ebtrac/Videonics-PP-1-Bluetooth-Mod/videonics processor plus ebtracMod.jpg

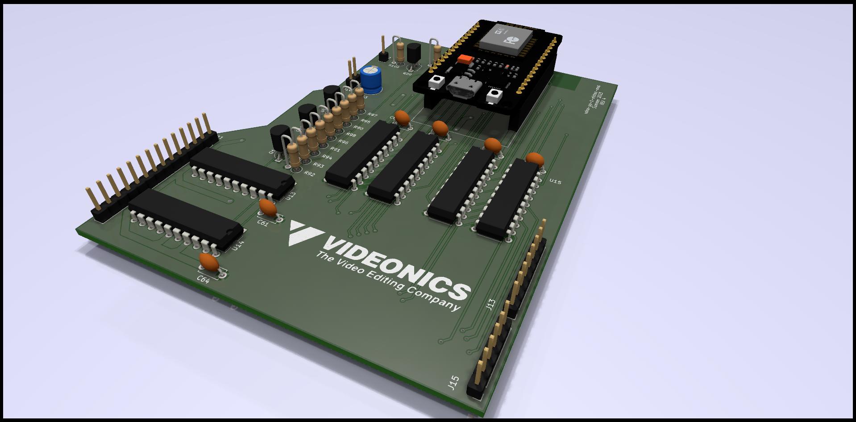
videonics processor plus ebtracMod.jpg
