ebtrac/Videonics-PP-1-Bluetooth-Mod/README.md

# Important Note  
This modification is not tested yet. Please check back when a fully tested modification has been developed.  
Modify your device at your own risk!  

# Videonics-PP-1-Bluetooth-Mod
 KiCad 6.0 Project Files for the Videonics Processor Plus and modifications for adding bluetooth control.
- [Schematics](20230723%20ebtrac_mod_pp1_rev4.pdf)
- [Firmware](https://github.com/ebtrac/pp1_esp32_control)
