ebtrac/Videonics-PP-1-Bluetooth-Mod/20230723 ebtrac_mod_pp1_rev4.pdf

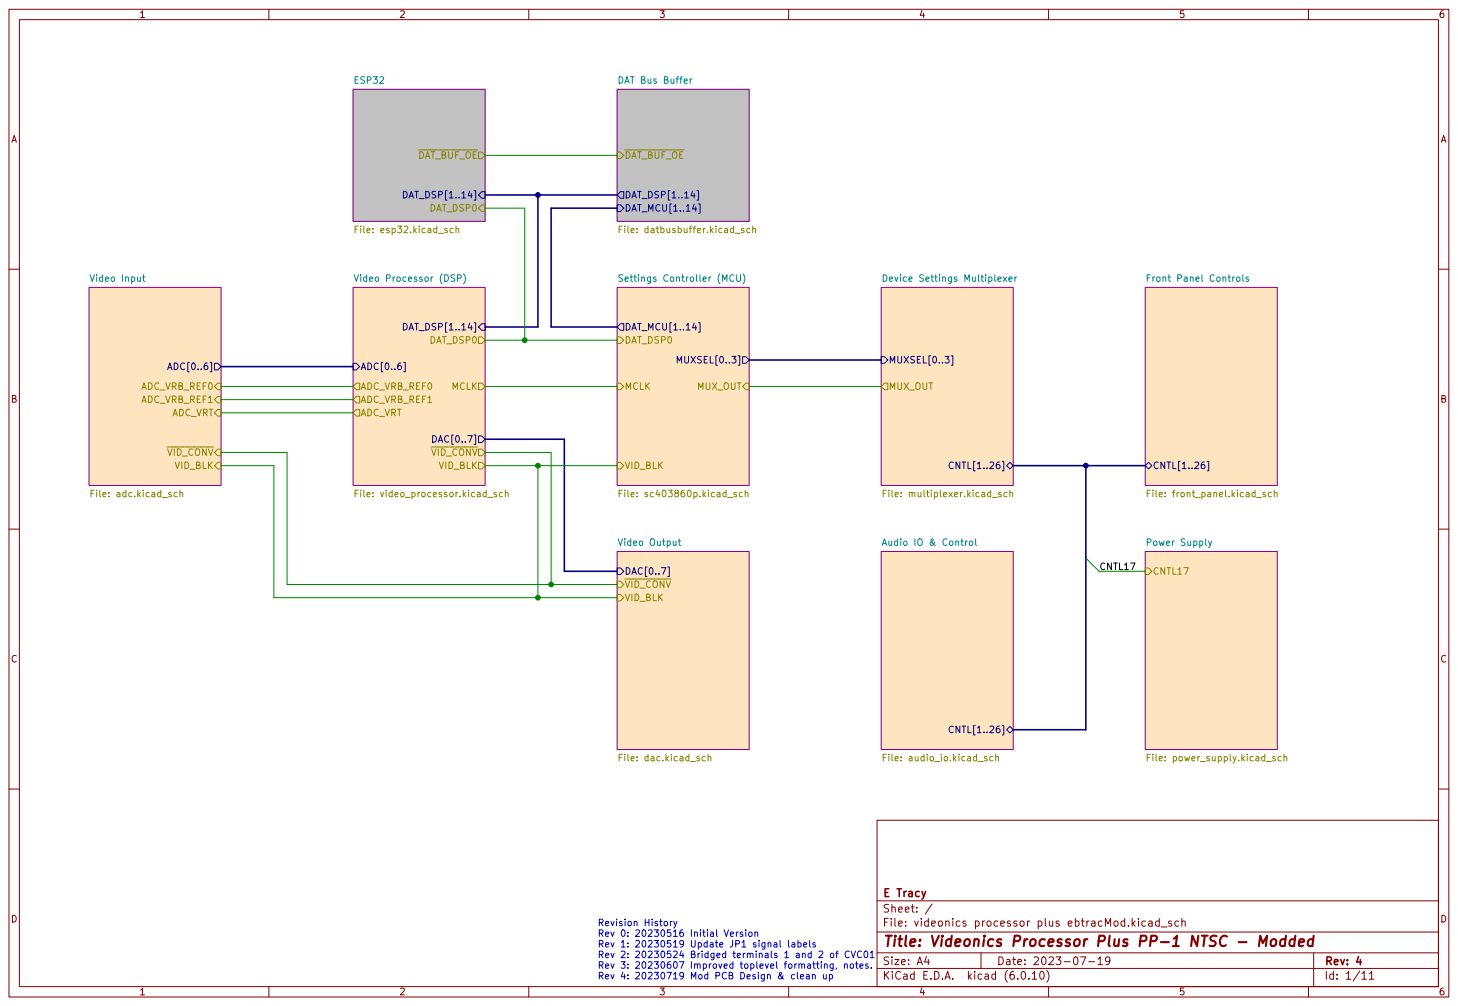
[picture p3: page 1]

CNTL[1..26] Front Panel Controls File: front_panel.kicad_sch

CNTL[1..26] MUX_OUT Device Settings Multiplexer

~{VID_CONV}
Video Output File: dac.kicad_sch VID_BLK

File: videonics processor plus ebtracMod.kicad_sch Sheet: / E Tracy

Id: 1/11 Title: Videonics Processor Plus PP-1 NTSC - Modded

Rev 2: 20230524 Bridged terminals 1 and 2 of CVC01
Rev 3: 20230607 Improved toplevel formatting, notes.
Rev 4: 20230719 Mod PCB Design & clean up

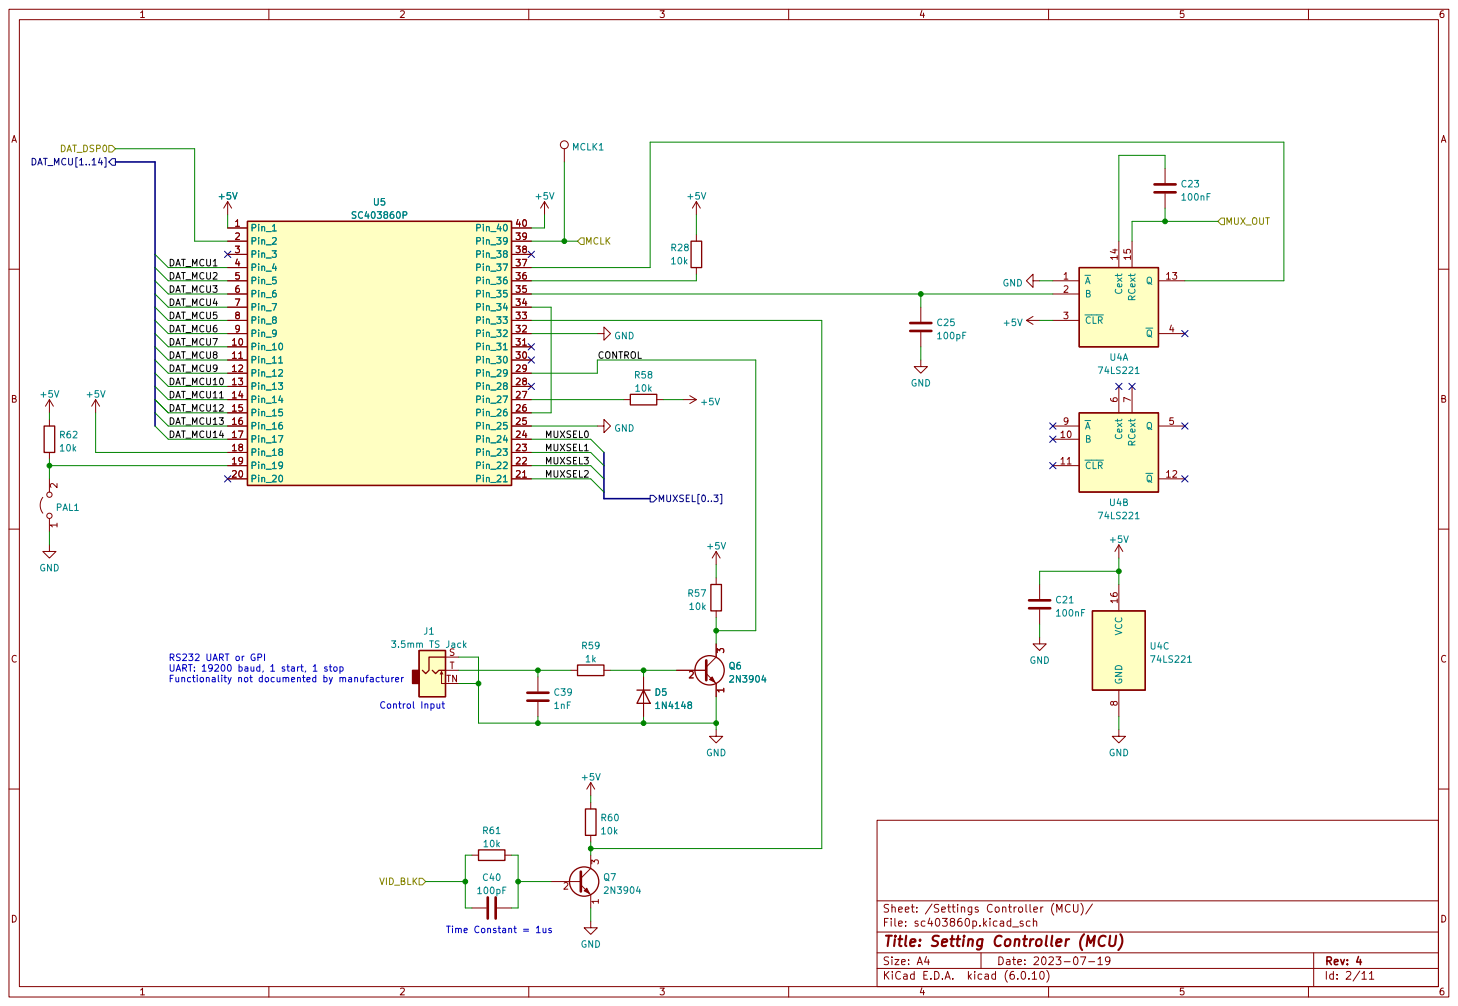
[picture p4: page 2]

Functionality not documented by manufacturer

File: sc403860p.kicad_sch
Id: 2/11 Title: Setting Controller (MCU)

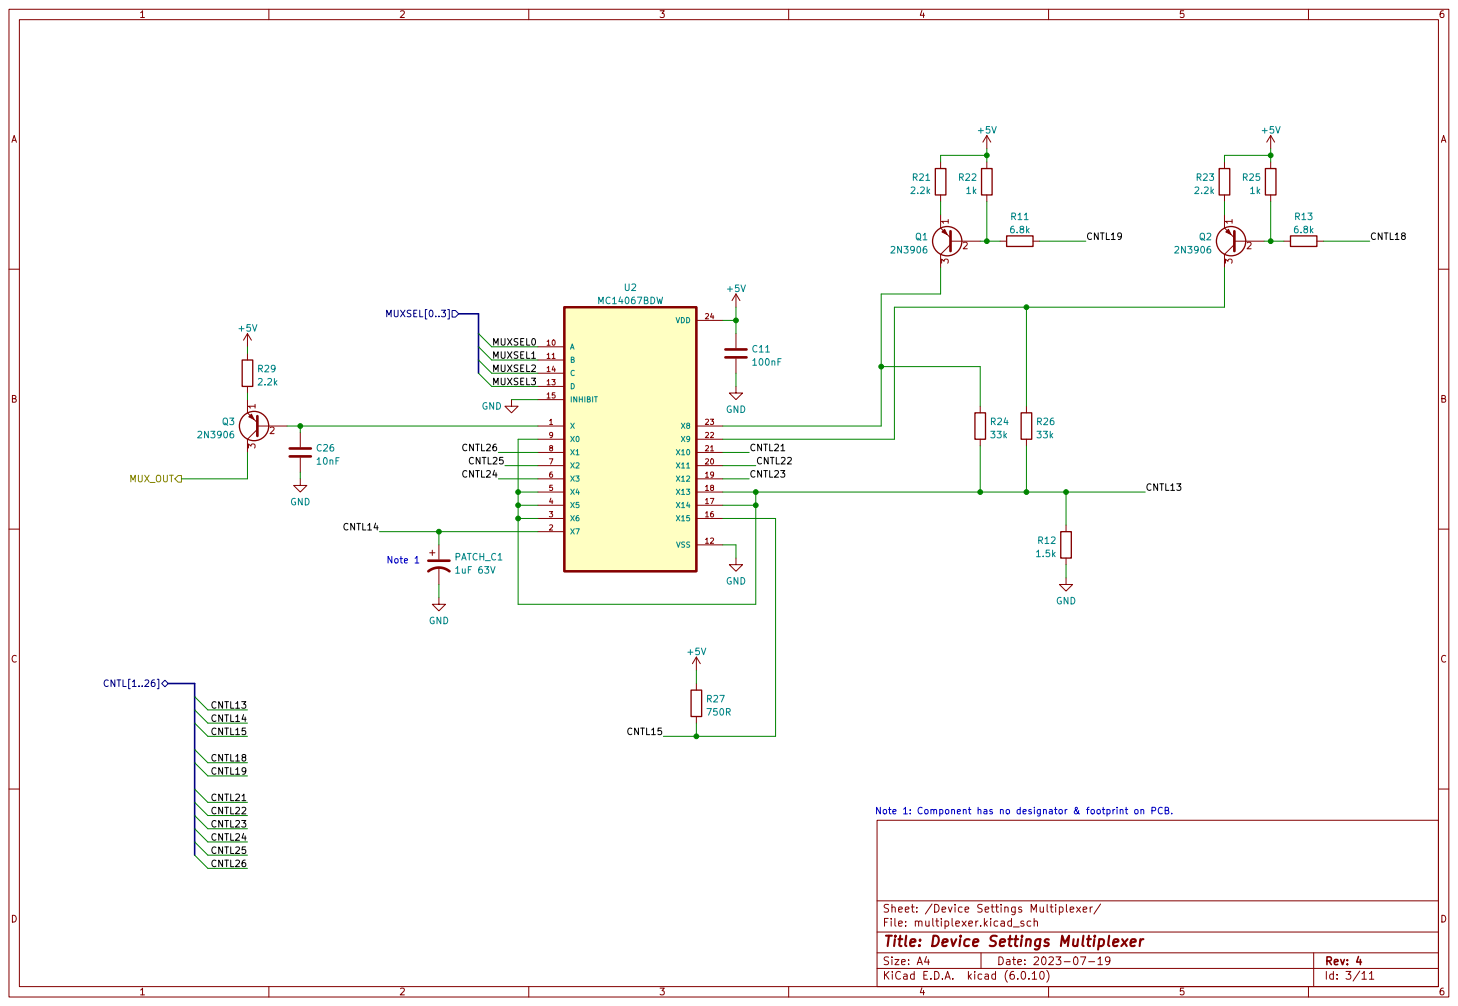
[picture p5: page 3]

Sheet: /Device Settings Multiplexer/
File: multiplexer.kicad_sch
Id: 3/11 Title: Device Settings Multiplexer

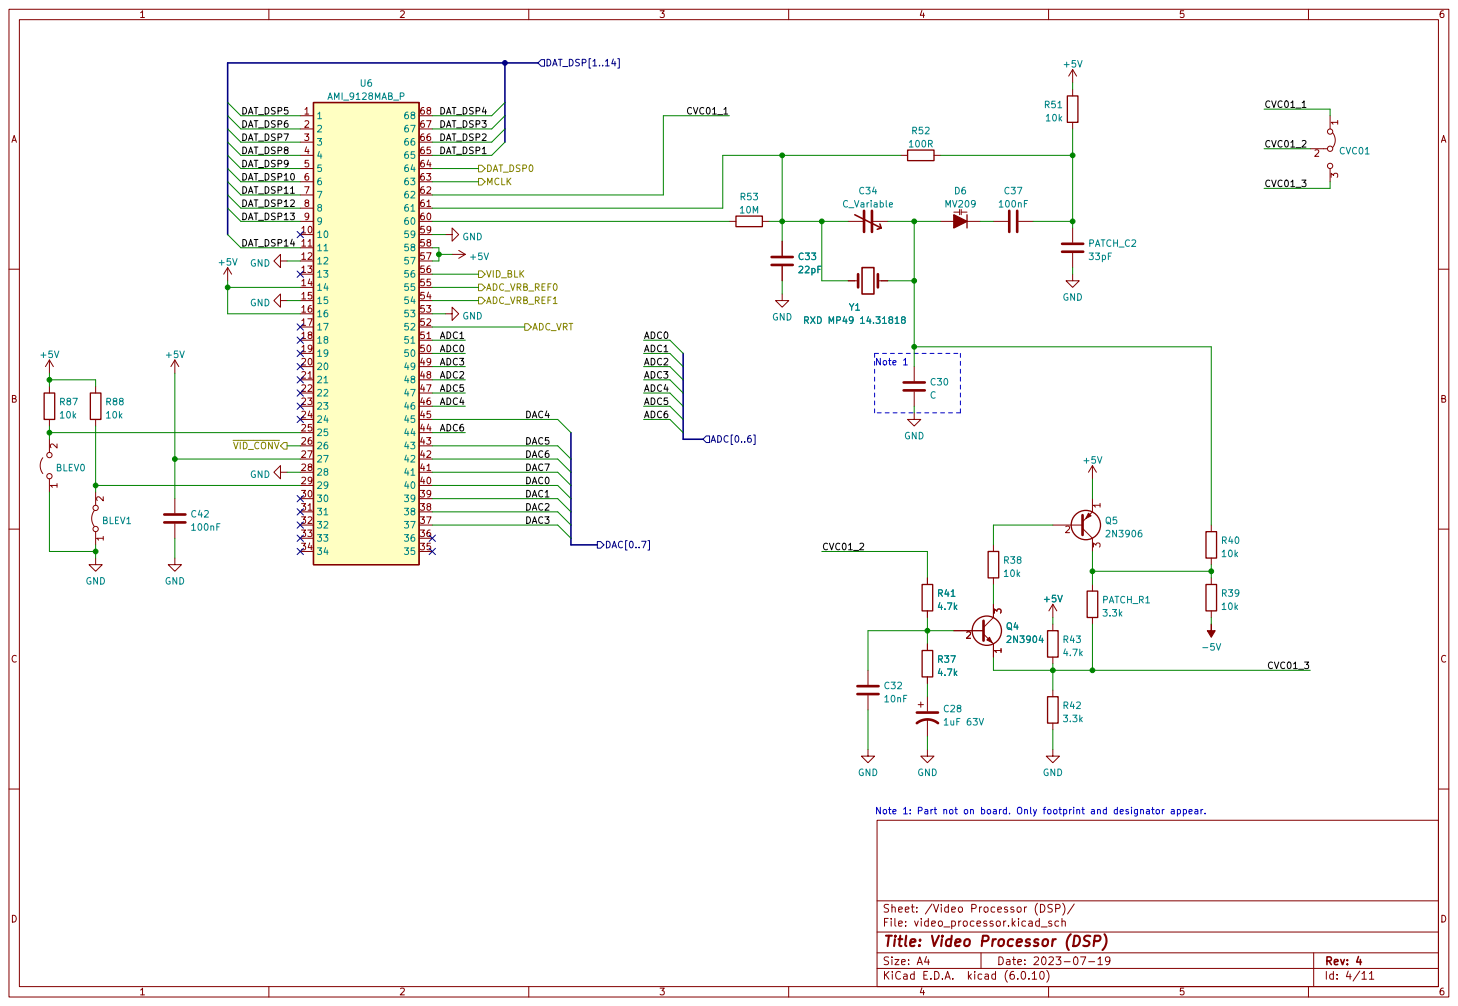
[picture p6: page 4]

Sheet: /Video Processor (DSP)/
File: video_processor.kicad_sch
Id: 4/11 Title: Video Processor (DSP)

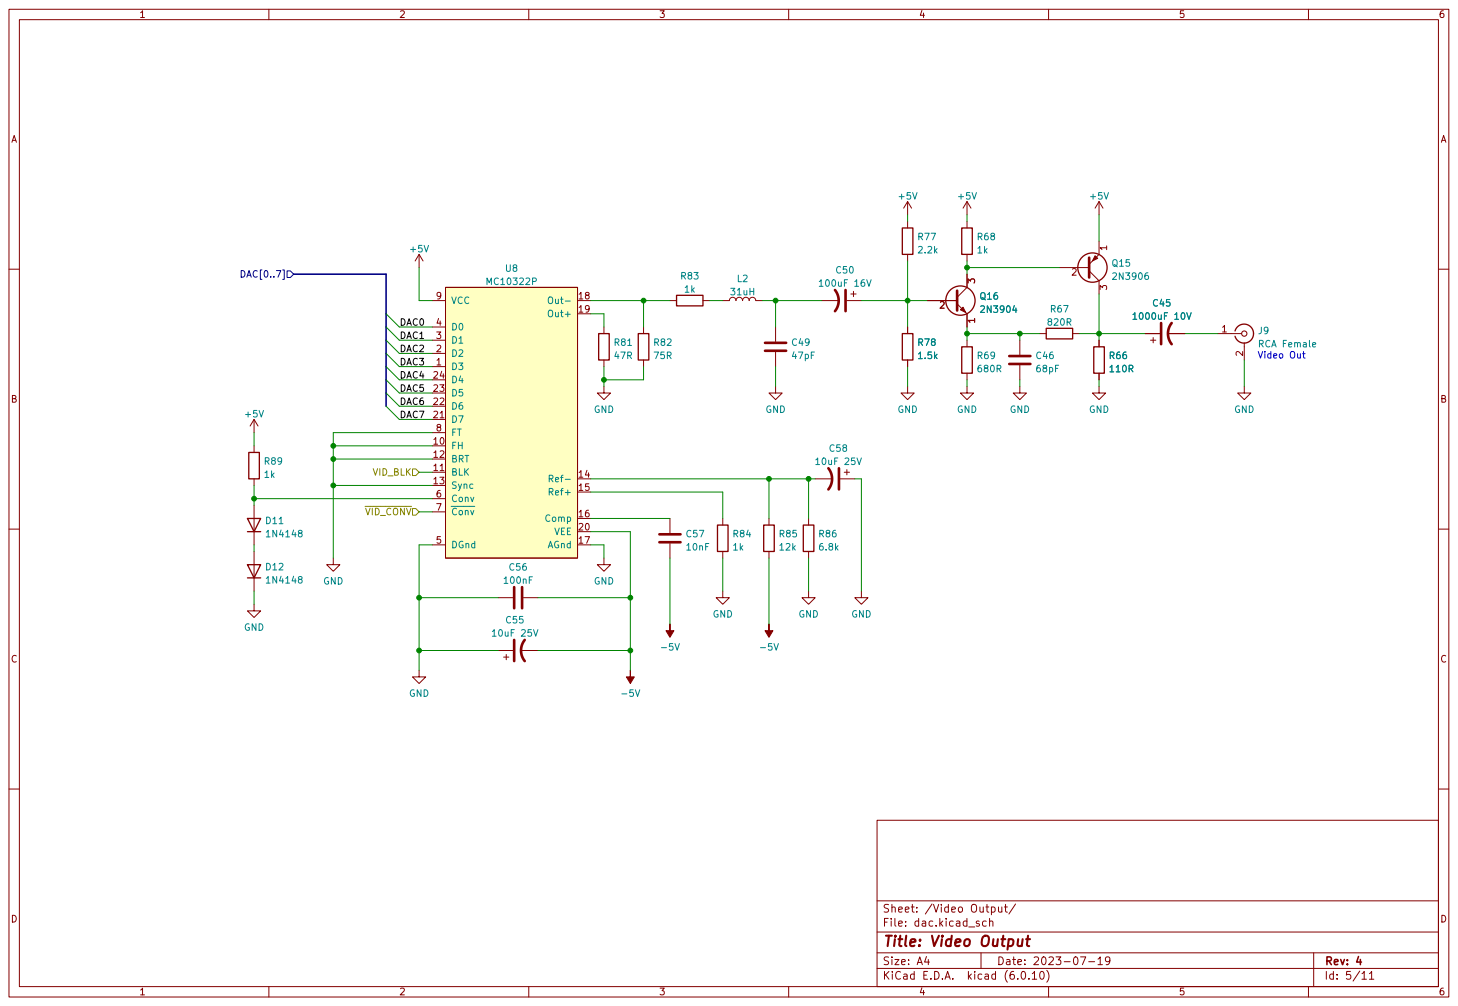
[picture p7: page 5]

Sheet: /Video Output/
File: dac.kicad_sch
Id: 5/11 Title: Video Output

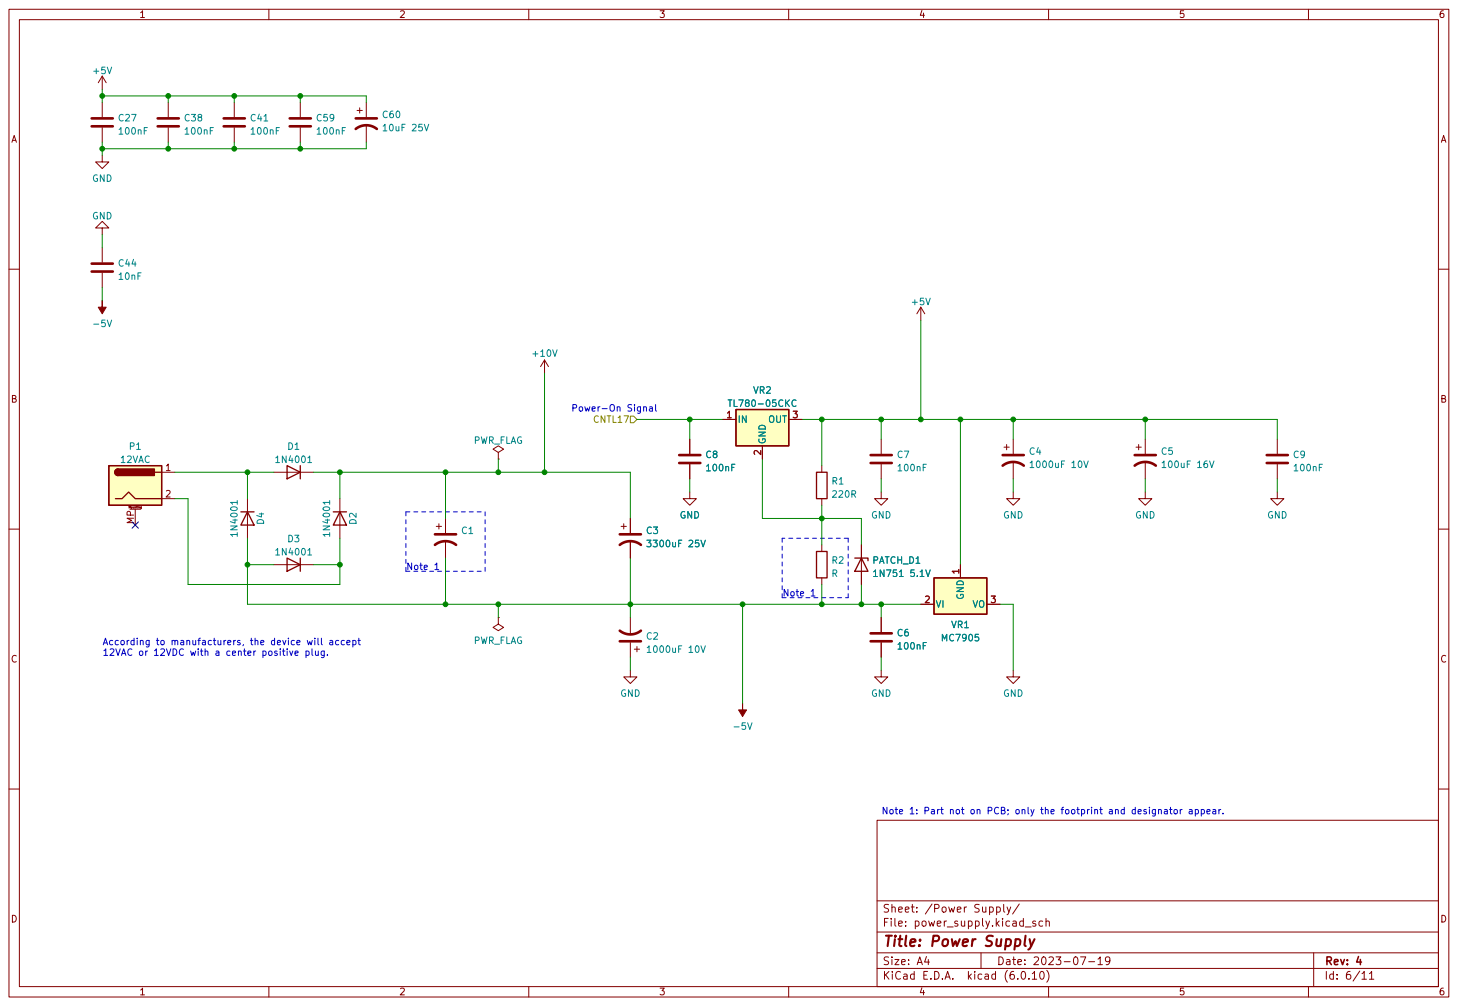
[picture p8: page 6]

100nF CNTL17 According to manufacturers, the device will accept

12VAC or 12VDC with a center positive plug.

File: power_supply.kicad_sch
Id: 6/11 Title: Power Supply

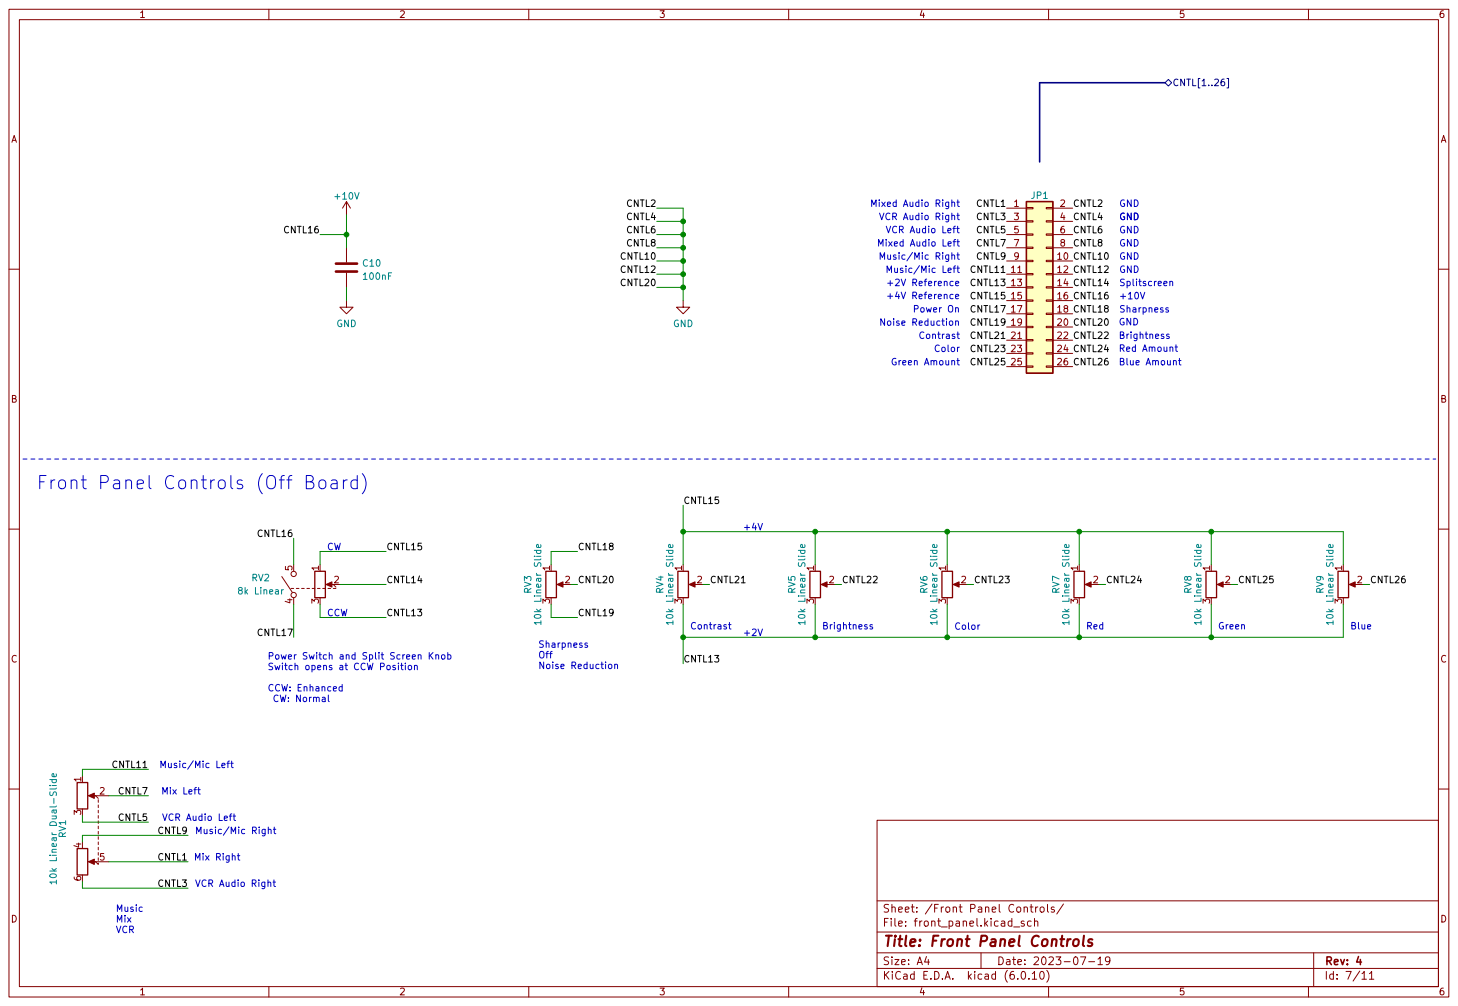
[picture p9: page 7]

VCR Audio Left VCR Audio Right Mixed Audio Left +2V Reference +4V Reference

Power Switch and Split Screen Knob
Switch opens at CCW Position CCW: Enhanced

CW: Normal Music/Mic Right

Mix Right VCR Audio Left

File: front_panel.kicad_sch Sheet: /Front Panel Controls/
Id: 7/11 Title: Front Panel Controls

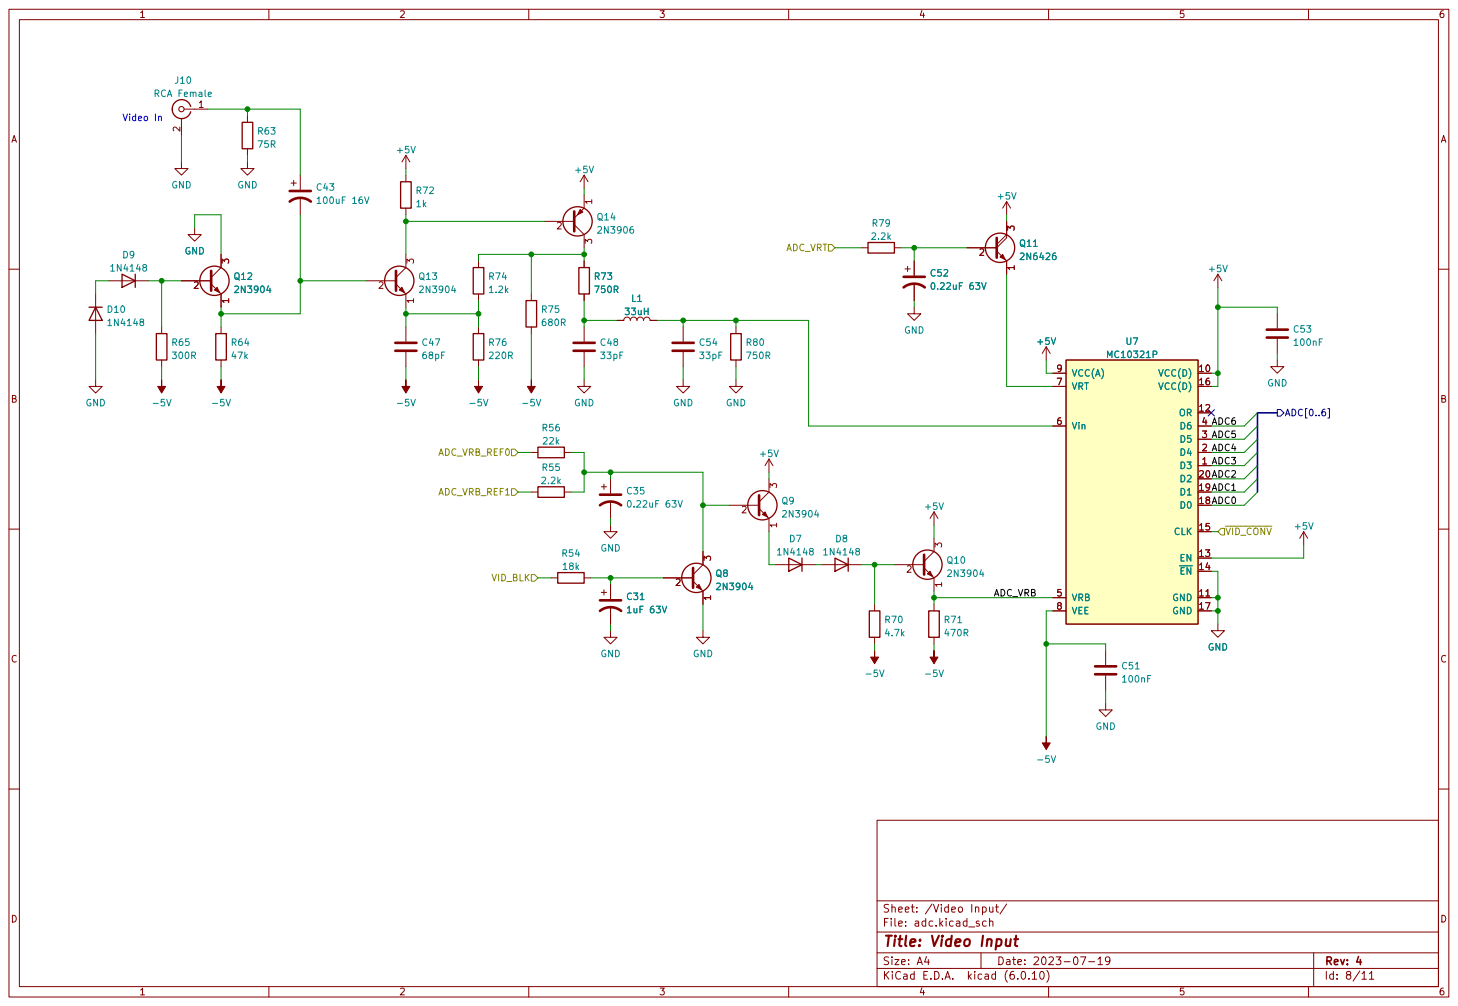
[picture p10: page 8]

3 U7 MC10321P D3 1 VCC(D) 10 GND 11 OR 12 EN 13 ~{EN} 14 CLK 15 VCC(D) 16 GND 17 D0 18 D1 19 D4 2 D2 20 D5 3 D6 4 VRB 5 Vin 6 VRT 7 VEE 8 VCC(A) 9 GND

File: adc.kicad_sch
Id: 8/11 Title: Video Input

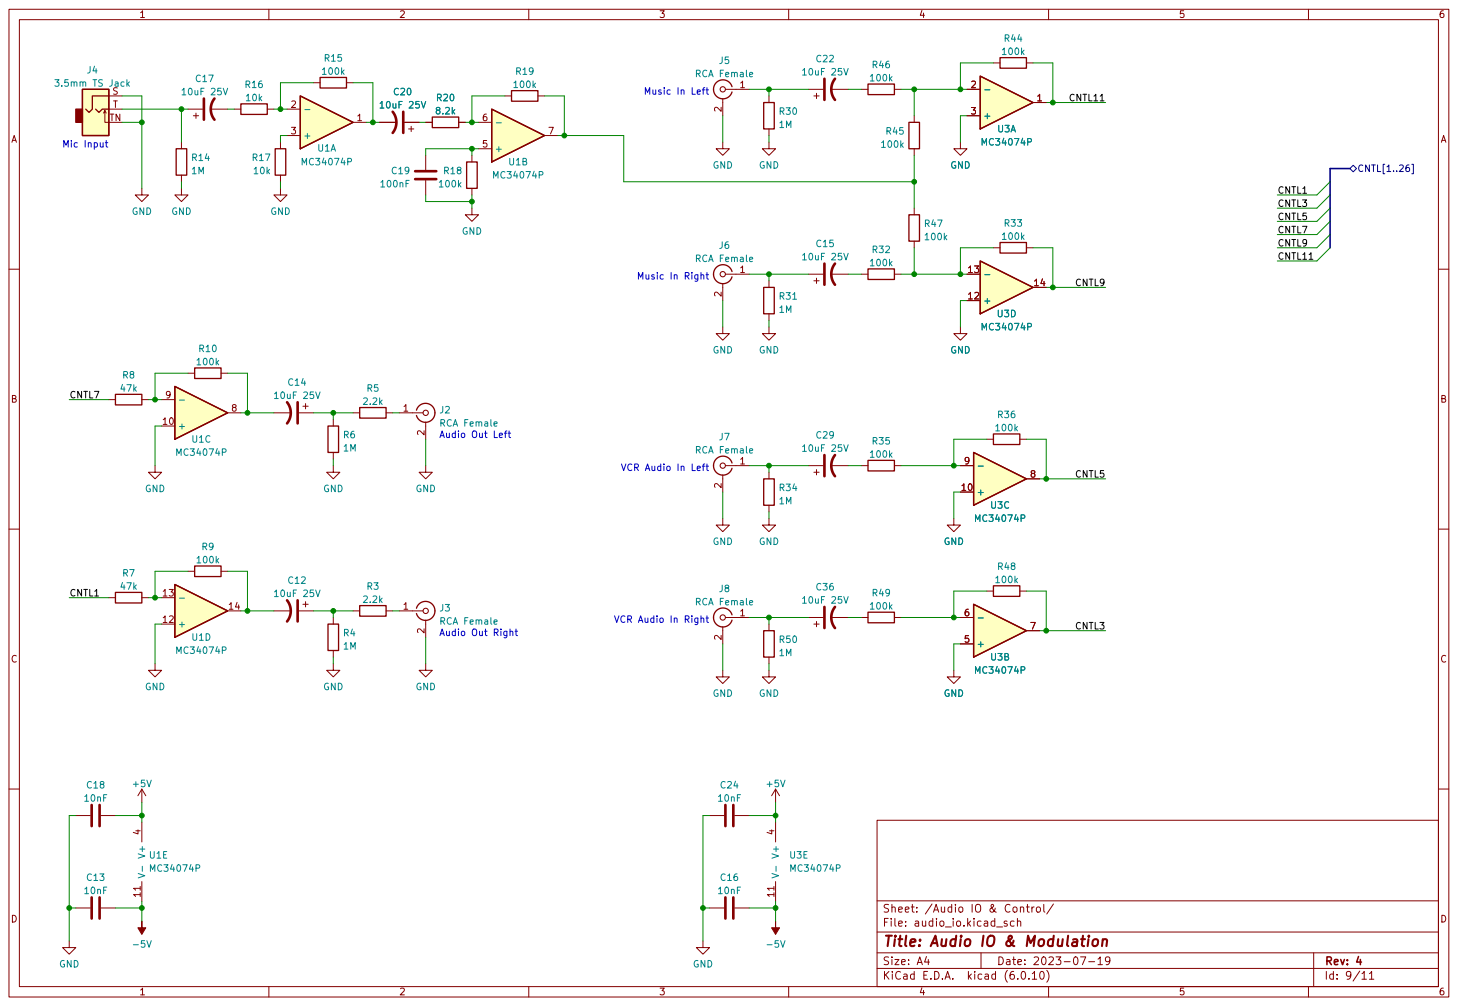
[picture p11: page 9]

Music In Right VCR Audio In Left C20

2 J8 RCA Female GND GND GND

2 J7 RCA Female GND GND

VCR Audio In Right

File: audio_io.kicad_sch Sheet: /Audio IO & Control/
Id: 9/11 Title: Audio IO & Modulation

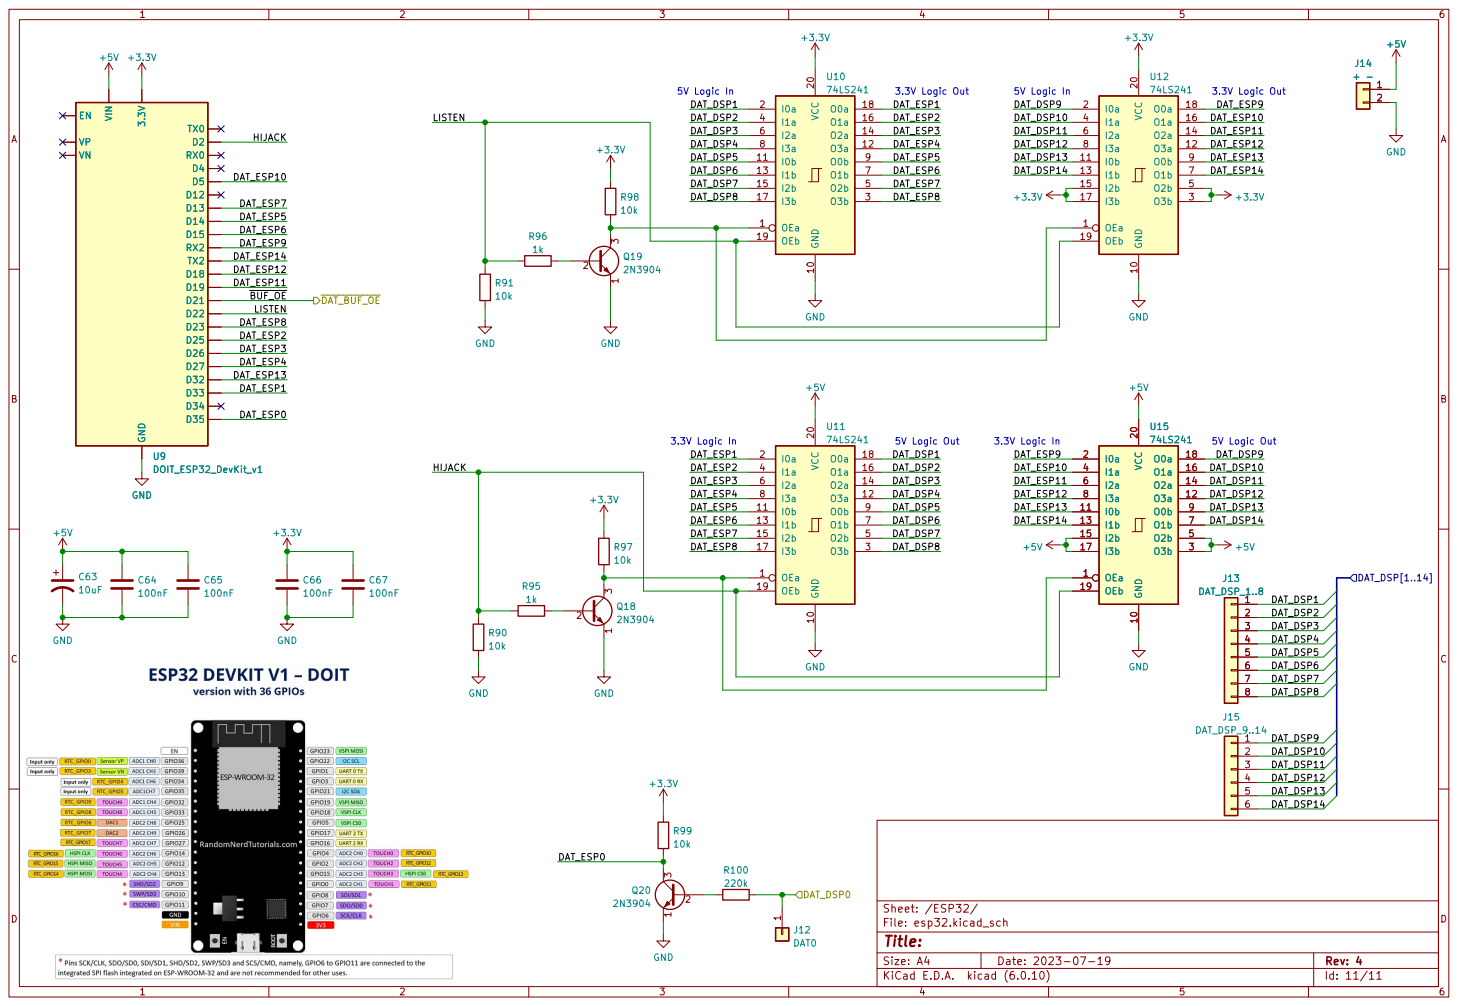
[picture p12: page 10]

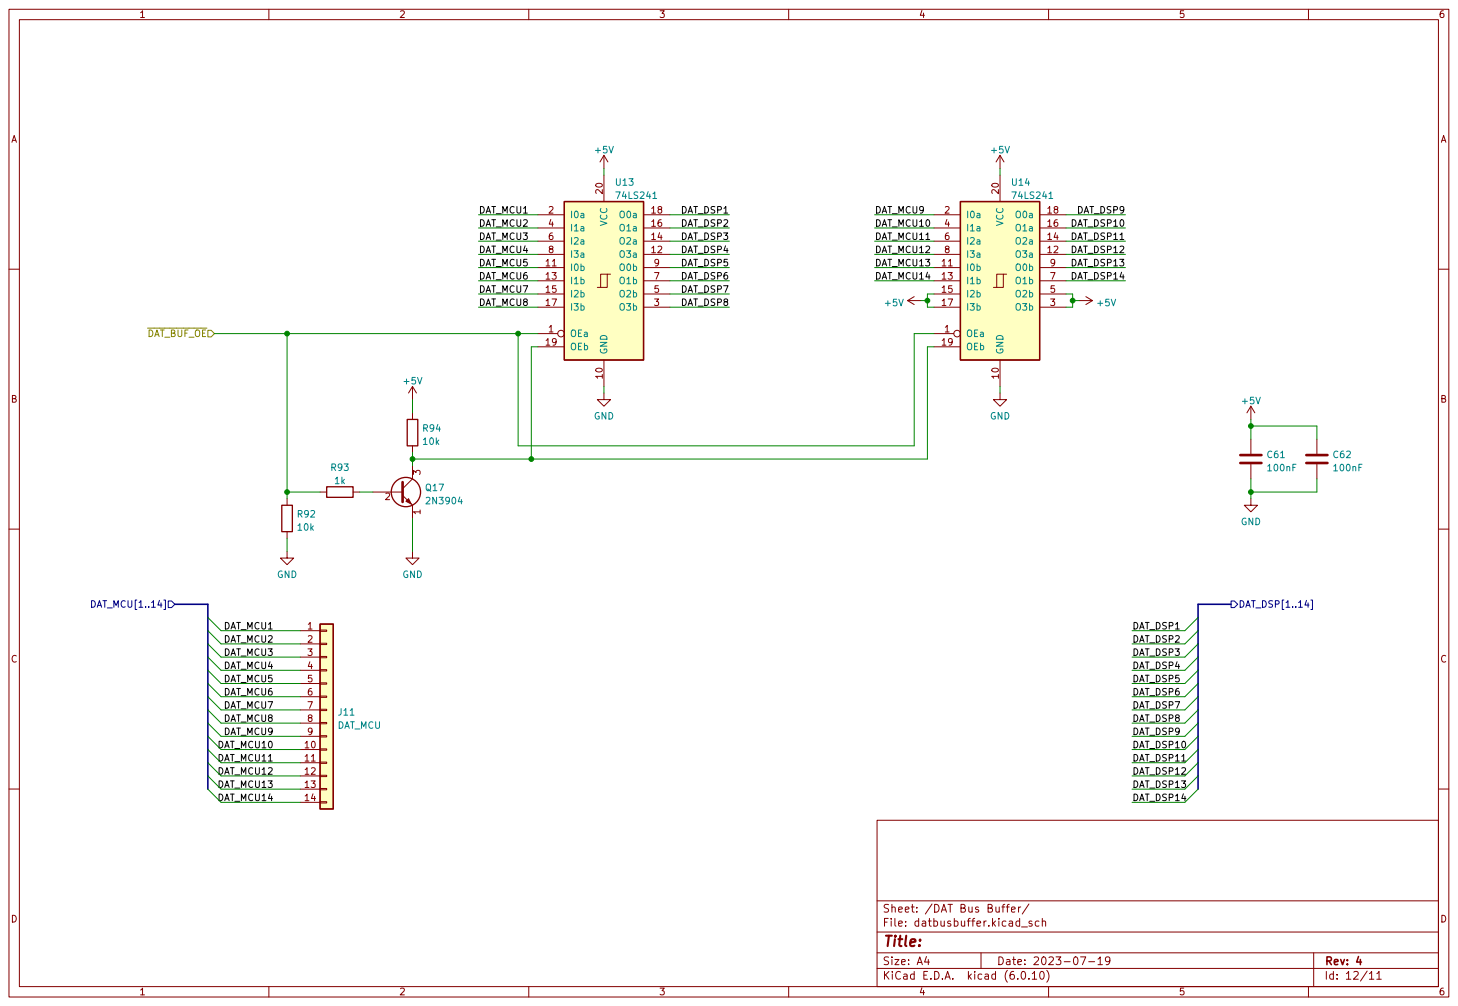
[picture p13: page 11]

File: datbusbuffer.kicad_sch Sheet: /DAT Bus Buffer/
Id: 12/11 Title:
