ebtrac/Videonics-PP-1-Bluetooth-Mod/videonics processor plus ebtracMod.kicad_pcb

## KiCad design videonics processor plus ebtracMod.kicad_pcb (2023-07-23)

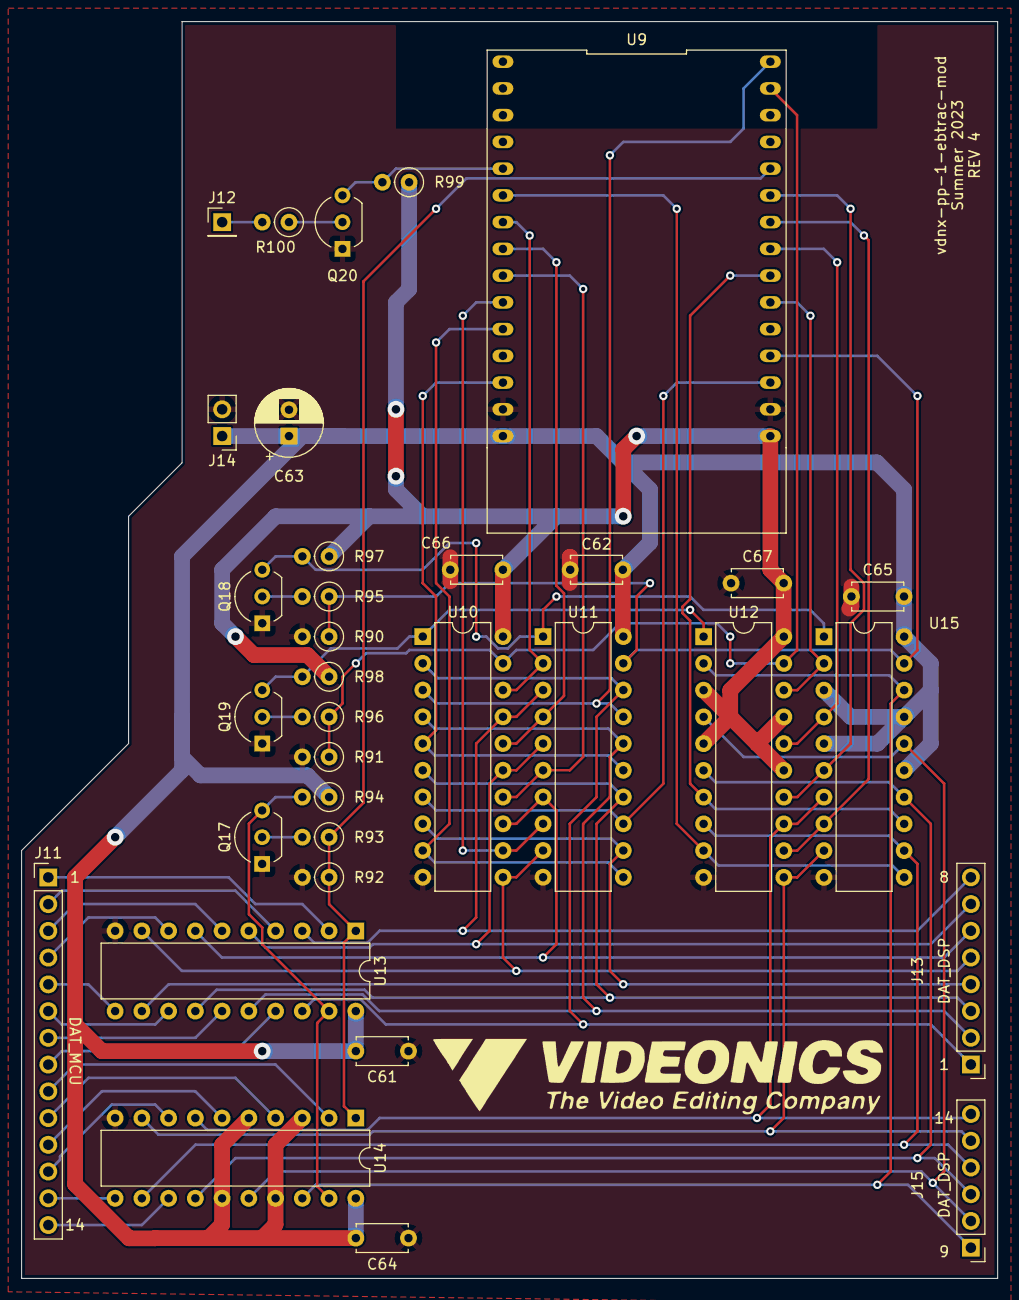
[picture p14: board videonics processor plus ebtracMod.kicad_pcb from above]

Board: 2 copper layers, 92.7 x 119.4 mm, 34 parts (0 on the bottom side), 57 nets.

Parts:
C61, C62, C64, C65, C66, C67: 100nF; C_Disc_D4.7mm_W2.5mm_P5.00mm
C63: 10uF; CP_Radial_D6.3mm_P2.50mm
J11: DAT_MCU; PinHeader_1x14_P2.54mm_Vertical
J12: DAT0; PinHeader_1x01_P2.54mm_Vertical
J13: DAT_DSP_1..8; PinHeader_1x08_P2.54mm_Vertical
J14: + -; PinHeader_1x02_P2.54mm_Vertical
J15: DAT_DSP_9..14; PinHeader_1x06_P2.54mm_Vertical
Q17, Q18, Q19, Q20: 2N3904; TO-92_Inline_Wide
R90, R91, R92, R94, R97, R98, R99: 10k; R_Axial_DIN0207_L6.3mm_D2.5mm_P2.54mm_Vertical
R93, R95, R96: 1k; R_Axial_DIN0207_L6.3mm_D2.5mm_P2.54mm_Vertical
R100: 220k; R_Axial_DIN0207_L6.3mm_D2.5mm_P2.54mm_Vertical
U9: DOIT_ESP32_DevKit_v1; DIP-30_1000_ELL
U10, U11, U12, U13, U14, U15: 74LS241; DIP-20_W7.62mm

Connections:
+3.3V: C66.1, C67.1, R97.1, R98.1, R99.1, U9.16 (3.3V), U10.20 (VCC), U12.3 (O3b), U12.5 (O2b), U12.15 (I2b), U12.17 (I3b), U12.20 (VCC)
+5V: C61.1, C62.1, C63.1, C64.1, C65.1, J14.1, R94.1, U9.15 (VIN), U11.20 (VCC), U13.20 (VCC), U14.3 (O3b), U14.5 (O2b), U14.15 (I2b), U14.17 (I3b), U14.20 (VCC), U15.3 (O3b), U15.5 (O2b), U15.15 (I2b), U15.17 (I3b), U15.20 (VCC)
/DAT Bus Buffer/DAT_DSP1: J13.1, U10.2 (I0a), U11.18 (O0a), U13.18 (O0a)
/DAT Bus Buffer/DAT_DSP2: J13.2, U10.4 (I1a), U11.16 (O1a), U13.16 (O1a)
/DAT Bus Buffer/DAT_DSP3: J13.3, U10.6 (I2a), U11.14 (O2a), U13.14 (O2a)
/DAT Bus Buffer/DAT_DSP4: J13.4, U10.8 (I3a), U11.12 (O3a), U13.12 (O3a)
/DAT Bus Buffer/DAT_DSP5: J13.5, U10.11 (I0b), U11.9 (O0b), U13.9 (O0b)
/DAT Bus Buffer/DAT_DSP6: J13.6, U10.13 (I1b), U11.7 (O1b), U13.7 (O1b)
/DAT Bus Buffer/DAT_DSP7: J13.7, U10.15 (I2b), U11.5 (O2b), U13.5 (O2b)
/DAT Bus Buffer/DAT_DSP8: J13.8, U10.17 (I3b), U11.3 (O3b), U13.3 (O3b)
/DAT Bus Buffer/DAT_DSP9: J15.1, U12.2 (I0a), U14.18 (O0a), U15.18 (O0a)
/DAT Bus Buffer/DAT_DSP10: J15.2, U12.4 (I1a), U14.16 (O1a), U15.16 (O1a)
/DAT Bus Buffer/DAT_DSP11: J15.3, U12.6 (I2a), U14.14 (O2a), U15.14 (O2a)
/DAT Bus Buffer/DAT_DSP12: J15.4, U12.8 (I3a), U14.12 (O3a), U15.12 (O3a)
/DAT Bus Buffer/DAT_DSP13: J15.5, U12.11 (I0b), U14.9 (O0b), U15.9 (O0b)
/DAT Bus Buffer/DAT_DSP14: J15.6, U12.13 (I1b), U14.7 (O1b), U15.7 (O1b)
/DAT Bus Buffer/DAT_MCU1: J11.1, U13.2 (I0a)
/DAT Bus Buffer/DAT_MCU2: J11.2, U13.4 (I1a)
/DAT Bus Buffer/DAT_MCU3: J11.3, U13.6 (I2a)
/DAT Bus Buffer/DAT_MCU4: J11.4, U13.8 (I3a)
/DAT Bus Buffer/DAT_MCU5: J11.5, U13.11 (I0b)
/DAT Bus Buffer/DAT_MCU6: J11.6, U13.13 (I1b)
/DAT Bus Buffer/DAT_MCU7: J11.7, U13.15 (I2b)
/DAT Bus Buffer/DAT_MCU8: J11.8, U13.17 (I3b)
/DAT Bus Buffer/DAT_MCU9: J11.9, U14.2 (I0a)
/DAT Bus Buffer/DAT_MCU10: J11.10, U14.4 (I1a)
/DAT Bus Buffer/DAT_MCU11: J11.11, U14.6 (I2a)
/DAT Bus Buffer/DAT_MCU12: J11.12, U14.8 (I3a)
/DAT Bus Buffer/DAT_MCU13: J11.13, U14.11 (I0b)
/DAT Bus Buffer/DAT_MCU14: J11.14, U14.13 (I1b)
/Device Settings Processor/DAT_DSP0: J12.1, R100.2
/ESP32/DAT_ESP0: Q20.3 (C), R99.2, U9.5 (D35)
/ESP32/DAT_ESP1: U9.7 (D33), U10.18 (O0a), U11.2 (I0a)
/ESP32/DAT_ESP2: U9.8 (D25), U10.16 (O1a), U11.4 (I1a)
/ESP32/DAT_ESP3: U9.9 (D26), U10.14 (O2a), U11.6 (I2a)
/ESP32/DAT_ESP4: U9.10 (D27), U10.12 (O3a), U11.8 (I3a)
/ESP32/DAT_ESP5: U9.11 (D14), U10.9 (O0b), U11.11 (I0b)
/ESP32/DAT_ESP6: U9.18 (D15), U10.7 (O1b), U11.13 (I1b)
/ESP32/DAT_ESP7: U9.13 (D13), U10.5 (O2b), U11.15 (I2b)
/ESP32/DAT_ESP8: U9.30 (D23), U10.3 (O3b), U11.17 (I3b)
/ESP32/DAT_ESP9: U9.21 (RX2), U12.18 (O0a), U15.2 (I0a)
/ESP32/DAT_ESP10: U9.23 (D5), U12.16 (O1a), U15.4 (I1a)
/ESP32/DAT_ESP11: U9.25 (D19), U12.14 (O2a), U15.6 (I2a)
/ESP32/DAT_ESP12: U9.24 (D18), U12.12 (O3a), U15.8 (I3a)
/ESP32/DAT_ESP13: U9.6 (D32), U12.9 (O0b), U15.11 (I0b)
/ESP32/DAT_ESP14: U9.22 (TX2), U12.7 (O1b), U15.13 (I1b)
/ESP32/HIJACK: R90.1, R95.1, U9.19 (D2), U11.19 (OEb), U15.19 (OEb)
/ESP32/LISTEN: R91.1, R96.1, U9.29 (D22), U10.19 (OEb), U12.19 (OEb)
/ESP32/~BUF_OE: R92.1, R93.1, U9.26 (D21), U13.1 (OEa), U14.1 (OEa)
GND: C61.2, C62.2, C63.2, C64.2, C65.2, C66.2, C67.2, J14.2, Q17.1 (E), Q18.1 (E), Q19.1 (E), Q20.1 (E), R90.2, R91.2, R92.2, U9.14 (GND), U9.17 (GND), U10.10 (GND), U11.10 (GND), U12.10 (GND), U13.10 (GND), U14.10 (GND), U15.10 (GND)
unnamed: Q17.2 (B), R93.2
unnamed: Q17.3 (C), R94.2, U13.19 (OEb), U14.19 (OEb)
unnamed: Q18.2 (B), R95.2
unnamed: Q18.3 (C), R97.2, U11.1 (OEa), U15.1 (OEa)
unnamed: Q19.2 (B), R96.2
unnamed: Q19.3 (C), R98.2, U10.1 (OEa), U12.1 (OEa)
unnamed: Q20.2 (B), R100.1
