ebtrac/Videonics-PP-1-Bluetooth-Mod/(commit log)

2023-07-08 Initial Design
    Problem: Level shifters need to be completely redesigned.
    [adc.kicad_sch, audio_io.kicad_sch, dac.kicad_sch, datbusbuffer.kicad_sch, datbusmux.kicad_sch, esp32.kicad_sch, front_panel.kicad_sch, multiplexer.kicad_sch]
2023-07-08 Redesigned Level Shifting Schematic
    [esp32.kicad_sch, videonics processor plus ebtracMod.kicad_sch]
2023-07-08 Changed level shifter inverter supply from 5V to 3.3V
    [esp32.kicad_sch, videonics processor plus ebtracMod.kicad_sch]
2023-07-17 Minor formatting updates
    [datbusbuffer.kicad_sch, esp32.kicad_sch, videonics processor plus ebtracMod.kicad_sch]
2023-07-17 update footprints
    [datbusbuffer.kicad_sch, esp32.kicad_sch, videonics processor plus ebtracMod.kicad_sch]
2023-07-18 smaller resistor footprint
    [datbusbuffer.kicad_sch, esp32.kicad_sch, videonics processor plus ebtracMod.kicad_sch]
2023-07-20 PCB Redesign Finished
    [esp32_dev_kit_v1_asm.stp, videonics processor plus ebtracMod.kicad_pcb]
2023-07-20 Add some labels and gerber files
    [videonics processor plus ebtracMod.kicad_pcb]
2023-07-21 misc updates
    [esp32.kicad_sch, videonics processor plus ebtracMod.kicad_sch]
2023-07-23 cleanup and rename subsheets, increment rev
    [adc.kicad_sch, audio_io.kicad_sch, dac.kicad_sch, datbusbuffer.kicad_sch, esp32.kicad_sch, front_panel.kicad_sch, multiplexer.kicad_sch, power_supply.kicad_sch]
2023-07-23 added bom exclusions for non mod components
    [adc.kicad_sch, audio_io.kicad_sch, dac.kicad_sch, esp32.kicad_sch, front_panel.kicad_sch, multiplexer.kicad_sch, power_supply.kicad_sch, sc403860p.kicad_sch]
2023-07-23 add bom with cost analysis
    [videonics processor plus ebtracMod.csv]
2023-07-23 updated cost
    [videonics processor plus ebtracMod.csv]
2023-07-23 added hyperlinks
    [videonics processor plus ebtracMod.csv]
2023-07-23 added schematics
2023-07-23 added rev 4 gerbers
